rajeet-04/ringquad/DESIGN.md

# Morphing Aerial-Ground Quad: Design Spec (v0.5)

**Current simulation design:** independent lightweight propellers and wheel drives, upright 90° fold, 100 mm ring-axis standoff, rear wheel carriers, front steering with 25° stops, physical crowned rims and self-collision enabled. Nominal mass budget is 1.98 kg. See [REDESIGN.md](REDESIGN.md) for the mechanism and regression evidence. Earlier shared-motor results below are historical; hardware qualification remains open.

Status: layout and fold geometry agreed, pre-build. Simulation first (ROS 2 Jazzy, Gazebo Harmonic), hardware later.

Items marked **(default)** are my proposals, not yet confirmed.

## 1. Concept

A quadrotor with four arms. Each arm ends in a ring propeller: the blades (spokes) inside the ring make thrust, and the outer surface of the ring is a tire.

- **Flight:** arms spread in an X, the ring propellers spin horizontally and fly the vehicle.
- **Ground:** arms fold down and inward with a twist, so each ring propeller stands up like a car wheel facing forward. The same motors now spin the rings as wheels, and the vehicle drives like an RC car.

Springs at each arm hinge give suspension in ground mode.

## 2. Hardware layout

| Part | Count | Role |
|---|---|---|
| Rotor/wheel motors | 4 | One per arm tip. Spin the ring propeller for thrust in flight, and drive it as a wheel on the ground. |
| Fold motor | 1 | In the body, at center-of-mass height. Drives all four arm hinges through a shared linkage or gear train. |
| Hinge springs | 4 | One per arm at the body joint. Suspension in ground mode. |

## 3. Fold geometry and sizing

Computed with `geometry.py` (body frame: x forward, y left, z up; front-left arm, others mirrored).

**Chosen design: plain front-to-back hinge, 80° fold, arm 45° down on the ground, 10° camber.**

At this arm angle the hinge axis that does the "fold inward with a spin" comes out as a pure front-to-back axis (computed: -1.0, -0.004, -0.005). So each arm needs only a plain hinge, not a tilted one, which is much easier to build. A single 80° rotation turns the arm from the diagonal X pose to 45° down, and turns the ring from horizontal to an upright wheel with 10° negative camber.

Inputs: 27 cm ring outer diameter (10-inch prop + rim), 3 cm tread, 16 x 16 x 8 cm body, ring plane offset 3.5 cm from the arm (above the arm in flight, outside the body on the ground), 1 cm minimum gaps.

| Quantity | Value |
|---|---|
| Arm length (hinge to ring centre) | **12 cm** |
| Gap between rings in flight | 6.0 cm |
| Gap between front and rear rings on the ground | 6.1 cm |
| Body ground clearance | 17 cm |
| Wheelbase / track | 33 / 30.5 cm (ratio 1.09, good for tank steering) |
| CoM height on the ground | 21 cm |
| Sideways tip-over threshold | 0.73 g |

Trade-off, same 12 cm arm: lowering the arm angle on the ground lowers the body (more stable, less clearance) but makes the hinge axis tilted.

| Arm angle down | Clearance | Tip-over | Wheelbase/track | Hinge |
|---|---|---|---|---|
| 20° | 12.7 cm | 0.87 g | 1.33 | tilted |
| 30° | 14.5 cm | 0.80 g | 1.24 | tilted |
| **45°** | **17.0 cm** | **0.73 g** | **1.09** | **plain front-to-back** |

Assumes the CoM is at hinge height and ignores arm and ring mass; recompute with real masses from CAD.

## 4. Geometry rules

- Rotor plane at center-of-mass height in flight.
- Hinges at center-of-mass height, so folding does not shift the center of mass much.
- Ring propellers do not overlap in flight.
- In ground mode, front and rear rings on each side must not touch, and the body must clear the ground.

## 5. Motors: flight vs ground

- **Same motors in both modes.** In flight they spin fast for thrust. On ground they spin slowly as wheels.
- **Spin direction changes between modes.** In flight, diagonal pairs spin opposite ways to cancel torque. On ground, both wheels on one side must spin the same way to drive forward. So at least two motors reverse direction when switching modes, and all four reverse for driving backward. Motors and controllers must be bidirectional.
- **Low-speed torque (hardware).** Drone motors and normal ESCs are poor at slow, high-torque spinning. For hardware, use motor controllers with field-oriented control and position encoders, which handle both fast flight and slow wheel driving. In simulation this is just a joint velocity/torque limit.
- Blades still spin while driving, but at wheel speeds (around 150 RPM at 2 m/s for a 10-inch ring) they make negligible thrust.

## 6. Fold mechanism requirements

- All four arms move together from one command (one motor, shared linkage).
- Holds position without continuous motor torque (worm gear, lead screw or linkage that locks at end of travel).
- **Arms locked rigid in flight; springs active only in ground mode (default).** A sprung arm in flight wobbles under thrust and upsets attitude control.

## 7. Driving and steering

- **Tank-style (skid) steering (decided):** turn by spinning the left and right wheels at different speeds. Needs no extra parts. The 1.09 wheelbase-to-track ratio keeps turning torque reasonable.

## 8. Modes

| Mode | Motors | Fold | Controller |
|---|---|---|---|
| FLY | fast, thrust and attitude | spread, locked | flight controller |
| TRANSITION_TO_GROUND | land, spin down, stop | folding | mode-switch node |
| DRIVE | slow, as wheels, direction per side | folded, springs active | ground controller (skid steer) |
| TRANSITION_TO_FLY | stopped, then spin up | unfolding, then lock | mode-switch node |
| HOLD | stopped | either | safety supervisor |

The mode-switch node gates everything: only one controller (flight or ground) commands the motors at a time.

## 9. Simulation plan (Gazebo Harmonic + ROS 2 Jazzy)

- Model: body, four arms on front-to-back revolute hinges (80° fold), four ring propellers on continuous joints, spring-damper on the hinges, ring collision shape for wheel contact.
- Fold: one command drives all four hinges (mimic joints or one controller for all four).
- Thrust: per-rotor thrust and drag torque from rotor speed (Gazebo multicopter motor model or our own plugin).
- **Controllers written in ROS 2 (default):** own flight controller and own skid-steer ground controller, with the mode-switch node between them. PX4 cannot switch vehicle type mid-mission without custom work, and an own controller is a stronger portfolio piece. Revisit PX4 for hardware.
- **Sensors (default):** IMU, depth camera, 2D LiDAR.

## 10. Demo mission (default)

Take off, fly over a wall, land, fold, drive through a low tunnel it cannot fly through, unfold, take off, and land at a goal.

## 11. Key tests

1. Hover stability with arms spread and locked.
2. Fold cycle: FLY to DRIVE and back; time per transition and no ring/body collisions during the fold.
3. Landing onto rings and spring-damper response in DRIVE.
4. Straight-line driving and skid-steer turns: slip and path error.
5. Motor direction switch between modes is correct for all four motors.
6. Fault case: one motor failure during transition, and the mode-switch response.

## 12. Findings from simulation

**Ring inertia dominates yaw.** Each ring (60 g at 12–13.5 cm radius) has about 12x the spin inertia of a plain 10-inch prop. When the mixer changes rotor speeds to make yaw torque, the reaction from spinning the rings up or down kicks the body in yaw like a reaction wheel. For a step command this kick is roughly 300x the aerodynamic drag torque the mixer plans for. With normal quad yaw gains the motors chattered between full and zero and the vehicle lost roll control. Fix: yaw gains much lower than roll/pitch (attitude 2, rate 0.4). The unit-test simulator models motor lag and ring inertia, so it catches this.
- Hardware consequence: ring mass is a first-order design parameter. Lighter rings (or rings that do not spin, i.e. a fixed duct with the prop inside) give much better yaw control.

**Skid-steer turning jams in the physics engine.** DART limits tyre friction per direction (a pyramid), so a tyre sliding forward still grips fully sideways. With wheelbase/track 1.09 the robot could not turn on the spot until it broke loose in jerks. Fix in simulation: sideways tread friction 0.6, forward 1.0 (it must stay below 0.92 x forward). A yaw-rate loop on the IMU then tracks turn commands (1.01 rad/s for 1 rad/s).
- Hardware consequence: on real tyres the friction circle helps, but a wheelbase/track ratio near or above 1 still makes skid steering scrub hard. Keep the track at least as wide as the wheelbase.

**Same motors fly and drive.** One motor model per ring takes signed speed commands. Positive = upward thrust in flight; on the ground the controller maps body speed and yaw rate to signed wheel speeds. Spin direction per motor is handled in `mixer.py`.

## 13. Realistic tests (v0.5)

The first simulation used ideal motors: the physics engine could spin the rings up with up to 50 Nm. Real hardware cannot. These tests replace the ideal assumptions with real limits and are now the default in Gazebo and the unit tests.

**What was added**
- Motors: 0.4 Nm peak (10-inch class, ~700 KV on 4S), rotor inertia, blade drag and an estimate of rim skin drag. Python model in `ringquad_control/plant.py`; in Gazebo as the spin joints' torque limit (0.33 Nm after blade drag) and damping. Gazebo spin-up matches the model (~300 rad/s^2 for the 60 g ring).
- Sensing: 8 ms delay plus position, velocity, attitude and gyro noise in the model sweeps; gyro and accelerometer noise on the Gazebo IMU.
- `scripts/realism_sweep.py` compares rotors and gains; `scripts/drive_test.py` checks ground steering.

**Flight results** (model, 8 ms delay + noise, final gains)

| Rotor | 1 m step settle | max tilt | 1.5 N gust | hover power | flight time (4S 3000 mAh) |
|---|---|---|---|---|---|
| plain 10-inch prop | 2.6 s | 16 deg | 22 cm | 137 W | 10.9 min |
| ring 20 g | 2.6 s | 16 deg | 22 cm | 333 W | 4.5 min |
| ring 40 g | 2.6 s | 17 deg | 22 cm | 353 W | 4.2 min |
| ring 60 g (spec) | 2.6 s | 17 deg | 22 cm | 386 W | 3.9 min |

- **The 60 g ring flies, but only with gentler control.** With the first roll/pitch tuning it diverges; at 0.7x and 0.6x it crashes on a 2.8 m diagonal move; 0.5x works (attitude bandwidth ~6 rad/s). The lighter rings and a plain prop fly at every scale tested. Final gains: 0.5x, kept for all rotors.
- **Rim drag is the biggest cost.** The rim moves at ~70 m/s at hover; its skin drag (estimated ~0.09 Nm per ring, about as much as the blades) more than doubles hover power. Flight time drops from ~11 min to ~4–4.5 min whatever the ring weight. This is an estimate and the first thing to measure on a thrust stand.
- **Heavy rings also waste power on noise.** With sensor noise the 60 g rings burn ~15% more than the 20 g rings, constantly spun up and down by the controller.
- In Gazebo with realistic motors and a noisy IMU: take-off 2.1 cm, waypoint + 90 deg yaw 2.6 cm / 0.1 deg, landing fine.

**Ground results**
- **All-rubber tread cannot reliably skid-steer.** Direct-drive motors push each wheel with at most ~0.4 Nm / 0.135 m = 3 N. The four wheels then make at most ~1.5–1.8 Nm of turning moment, while the tyres' sideways grip resists with ~1.6 Nm (more on real rubber). In Gazebo, turning on the spot gave 0.00 rad/s, and large left/right speed differences made the wheels fight and stall the robot. The yaw-rate loop is now limited with anti-windup so it never stalls the drive.
- **Never fold with spinning rings.** A ring spinning at landing speed holds ~0.4 Nms; tipping its axis twists the robot. The controller now waits until all rings are below 5 rad/s.
- **Fold slowly.** A fast fold drags the ring edges over the floor against the motor brake; with realistic torque it twisted the robot by up to 80 deg. The fold is now ramped at 0.4 rad/s (~3.5 s); the twist dropped to about 1–2 deg.
- **Candidate fix: omni rollers on the tread.** Passive rollers around the rim cut sideways friction to ~0.05 and the turning resistance to ~0.14 Nm. In Gazebo (`tread:=omni`) arc turns then track exactly (0.30 / 0.60 / 0.99 rad/s for 0.3 / 0.6 / 1.0 requested), but the robot has no sideways grip and skids on corrections. `tread:=mixed` (omni front, rubber rear) is the standard answer (it pivots about the rear axle like a wheelchair on casters) and also tracks arcs exactly, but line following was erratic and inconsistent between runs, while the same follower converges in a kinematic model with lag.
- **Simulation limit.** Results that depend on tyre contact (directional friction on a cambered ring edge, rollers) were not consistent between runs in DART: with the rubber tread a 0.3 rad/s turn request while driving gave 0.00 rad/s in one session and 0.30 rad/s in another. They should be settled on a physical test rig, not by more simulation tuning.

**Historical cylinder-contact demo results (before the tunnel-control branch).** The flight legs work. The tunnel leg fails: with the spec rubber tread the robot cannot steer and needs ~0.9 deg alignment to clear the 7–8 cm gaps over 4 m, which landing + folding do not reliably give (+-2 deg); with the mixed tread, line following is not yet reliable in simulation. The mission now lines up in the air, checks alignment after folding, hops and retries if needed, and stops safely on drift. The recorded demo in `media/` was made with ideal motors before these tests.

**Would it work if built?** Flight: yes with a 20–40 g ring (or the 60 g ring with gentle control), but expect ~4 min flights unless rim drag is lower than estimated. Ground: not with an all-rubber tread on grippy floors; it needs a steerable tread (mixed omni/rubber is the best candidate) or turns done in the air.

## 14. Recommended physical tests before building the full robot

1. **Thrust stand, one ring propeller** (60 g and a ~20 g carbon version): thrust, shaft power and spin-up time vs speed. Confirms or kills the rim-drag estimate and the motor sizing.
2. **Folding arm prototype:** play, locking, weight, and folding with the ring stopped vs spinning.
3. **Two-axle test cart** with the folded geometry and the candidate treads (rubber, omni, mixed) on the target floors: turning on the spot, arcs, straight-line drift.

## 15. Open questions

- Ring weight and whether the ring spins with the prop (see findings and section 13).
- Tread: rubber, omni or mixed (section 13).
- Fold motor type: servo, geared brushless or lead screw.
- Failure policy when a motor fails in DRIVE.

## 16. Status and next steps

Done in simulation: model, fold, flight (take-off, waypoint + yaw, land), driving, mode switching; unit and end-to-end tests. Demo course (wall + tunnel) and autonomous mission (`demo.launch.py`), recorded in `media/` with ideal motors. Realistic motors, drag and sensor noise are now the default (section 13): the original tunnel leg failed; isolated validation of the updated mission is documented in section 17 and SIMULATION_RESULTS.md.

The mission uses known waypoints and ground-truth odometry; it does not perceive the course yet.

Next:
1. The physical tests in section 14, then pick the ring weight and tread.
2. Hinge spring-damper suspension in DRIVE (currently a stiff hold).
3. State estimation from IMU instead of ground-truth odometry.
4. Sensors (depth camera, 2D LiDAR) so the robot finds the wall and tunnel itself.
5. GPU rendering (Vulkan through Podman's libkrun to Metal) to speed up the GUI and recording.

## 17. Tunnel-control branch (2026-11-13)

The experiment uses a convex rounded tread collision mesh and DART's Bullet collision detector. The full demo defaults to omni tread; mixed and rubber are also exercised in isolated full-mission tests; see SIMULATION_RESULTS.md. This is a contact approximation, not a model of individual passive rollers or proof of hardware capability.

The mission now actively aligns on the ground to within 1 degree before forward motion, with a 60 s ground-alignment timeout and compensated aerial retries, rather than accepting up to 10 degrees after folding. It uses ROS simulation time, a landing point at x=3.8 m, and retains the original 5 cm strict cross-track stop. Headless launch is available through `gui:=false`. `scripts/demo_test.py` starts fresh worlds and fails on abort, timeout, or missing completion; run it in the sourced ROS workspace.

The original tests did not isolate Gazebo transport between runs. Orphaned servers were found during follow-up validation, so those inconsistent runs cannot distinguish contact dynamics from cross-talk. The corrected harness uses locked ROS domains, unique Gazebo partitions, and full process-group cleanup. Ground-alignment stalls now use the existing aerial retry with measured heading compensation, bounded to three attempts. See SIMULATION_RESULTS.md for isolated mixed/rubber/omni validation; none of these tests establish hardware steering bandwidth.

## 18. Isolated follow-up validation

The follow-up fixes test isolation/cleanup, noisy low-rate yaw integration, and stalled alignment recovery. Waypoint completion also waits for yaw convergence. The final ground alignment allowance is 60 simulated seconds, with three landing attempts and the original 5 cm strict cross-track stop. Two isolated complete missions per tread (mixed, rubber, omni) passed; see SIMULATION_RESULTS.md for per-run timing, configuration differences, and remaining steering-bandwidth limitations. No steering mechanism or motor/friction limit was changed.

## 19. Optional front-steering mechanism

The user-authorized hardware variant adds two 20 g front steering knuckles and ideal positive locks that engage when the arms are below 75 degrees fold. Ground control uses Ackermann angles and wheel speeds; flight allocation accounts for added mass and forward CoM shift. Servo-only steering hold caused a flight regression and was replaced by the explicit lock. The fixed-wheel model remains the default. See STEERING.md and SIMULATION_RESULTS.md for hardware assumptions, measured yaw tracking, and complete-mission validation.
