rajeet-04/ringquad/hardware-blockers/fixtures/synthetic-thrust.csv

rotor | omega_rad_s | thrust_N | current_A | voltage_V | temperature_C
fl | 400 | 1.3439999999999999 | 10 | 14.8 | 45
fl | 500 | 2.0999999999999996 | 10 | 14.8 | 45
fl | 600 | 3.0239999999999996 | 10 | 14.8 | 45
fl | 700 | 4.116 | 10 | 14.8 | 45
fl | 800 | 5.3759999999999994 | 10 | 14.8 | 45
fl | 900 | 6.803999999999999 | 10 | 14.8 | 45
fl | 1000 | 8.399999999999999 | 10 | 14.8 | 45
fl | 1040 | 9.085439999999998 | 10 | 14.8 | 45
fr | 400 | 1.2767999999999997 | 10 | 14.8 | 45
fr | 500 | 1.9949999999999994 | 10 | 14.8 | 45
fr | 600 | 2.8727999999999994 | 10 | 14.8 | 45
fr | 700 | 3.9101999999999992 | 10 | 14.8 | 45
fr | 800 | 5.107199999999999 | 10 | 14.8 | 45
fr | 900 | 6.463799999999998 | 10 | 14.8 | 45
fr | 1000 | 7.979999999999998 | 10 | 14.8 | 45
fr | 1040 | 8.631167999999999 | 10 | 14.8 | 45
rl | 400 | 1.2096 | 10 | 14.8 | 45
rl | 500 | 1.89 | 10 | 14.8 | 45
rl | 600 | 2.7216 | 10 | 14.8 | 45
rl | 700 | 3.7043999999999997 | 10 | 14.8 | 45
rl | 800 | 4.8384 | 10 | 14.8 | 45
rl | 900 | 6.1236 | 10 | 14.8 | 45
rl | 1000 | 7.56 | 10 | 14.8 | 45
rl | 1040 | 8.176896 | 10 | 14.8 | 45
rr | 400 | 1.1423999999999999 | 10 | 14.8 | 45
rr | 500 | 1.785 | 10 | 14.8 | 45
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
