rajeet-04/ringquad/hardware-blockers/cad/rear_v_race.step

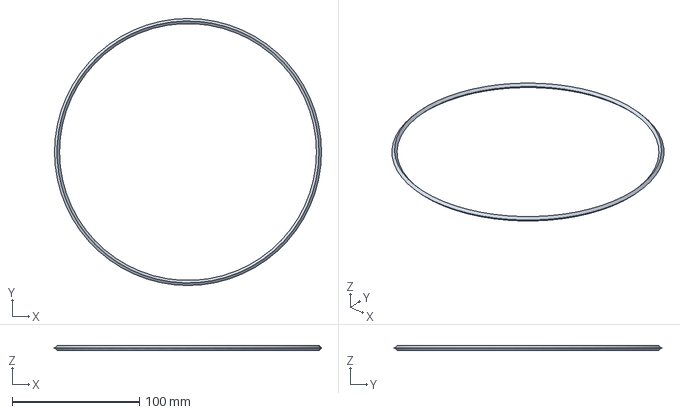
[picture p3: CAD file, 2026-11-13]
hardware-blockers/cad/rear_v_race.step
210.0 x 210.0 x 4.00 mm
