rajeet-04/ringquad/src/ringquad_description/meshes/crowned_rim.stl

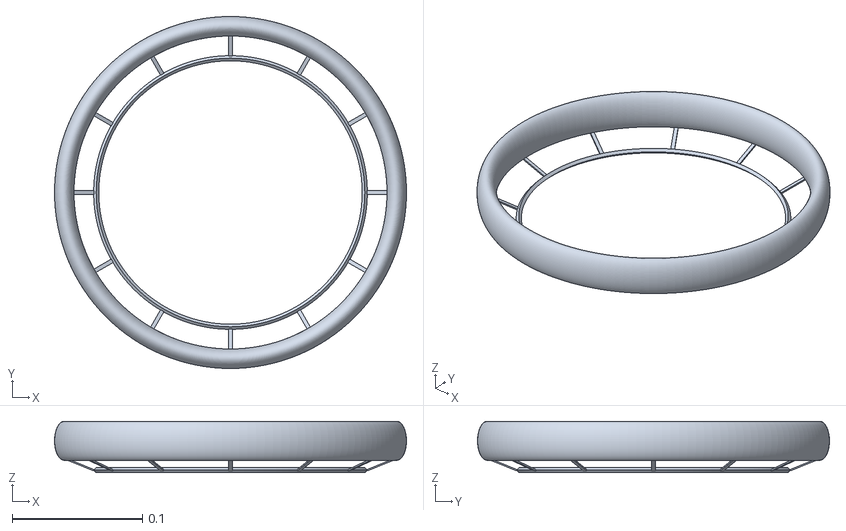
[picture p4: CAD file, 2026-11-13]
src/ringquad_description/meshes/crowned_rim.stl
0.27 x 0.27 x 0.0395
