rajeet-04/ringquad/src/ringquad_description/meshes/rear_race_segments/race_14.stl

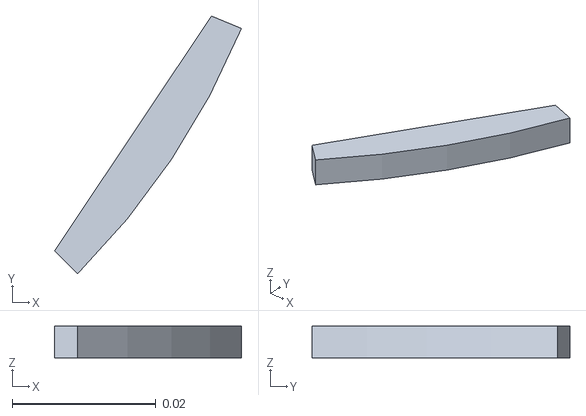
[picture p5: CAD file, 2026-11-13]
src/ringquad_description/meshes/rear_race_segments/race_14.stl
0.026 x 0.0359 x 0.0044
