rajeet-04/ringquad/src/ringquad_description/meshes/rear_tab_segments/tab_9.stl

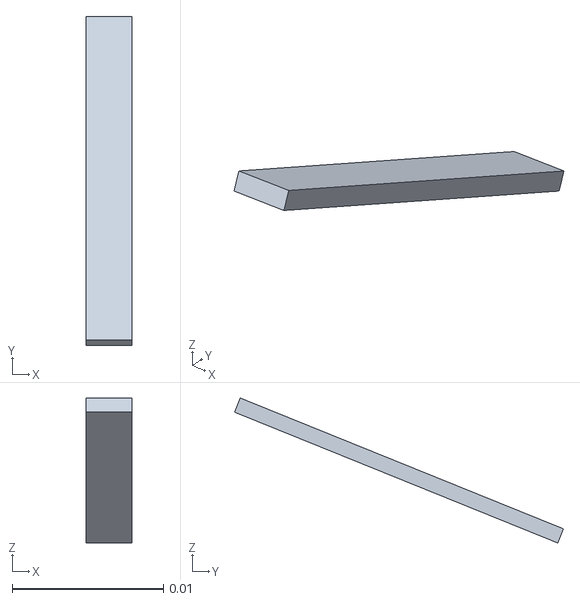
[picture p6: CAD file, 2026-11-13]
src/ringquad_description/meshes/rear_tab_segments/tab_9.stl
0.00303 x 0.0218 x 0.0096
