rajeet-04/ringquad/hardware-blockers/cad/latch_tongue.step

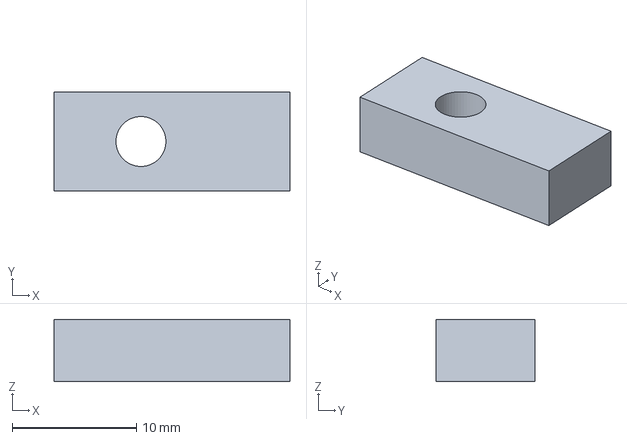
[picture p7: CAD file, 2026-11-13]
hardware-blockers/cad/latch_tongue.step
19.0 x 8.00 x 5.00 mm
