rajeet-04/ringquad/src/ringquad_description/meshes/crowned_tread_hull.stl

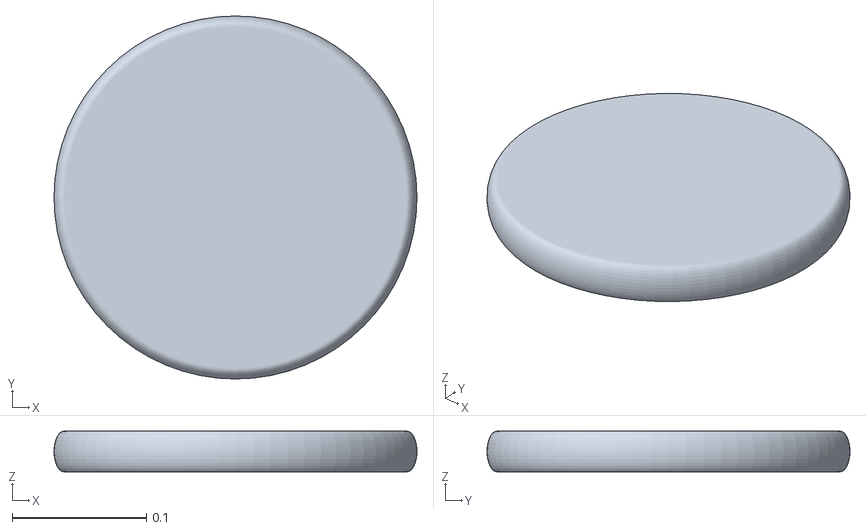
[picture p8: CAD file, 2026-11-13]
src/ringquad_description/meshes/crowned_tread_hull.stl
0.27 x 0.27 x 0.0304
