rajeet-04/ringquad/src/ringquad_description/meshes/rear_tab_segments/tab_7.stl

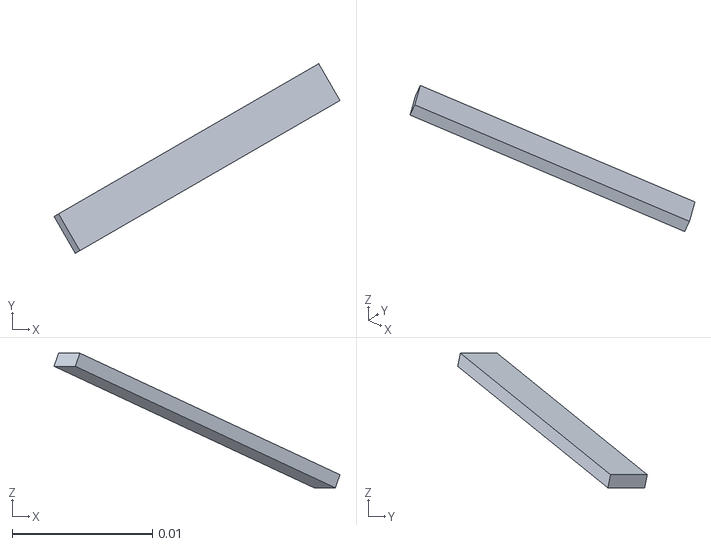
[picture p9: CAD file, 2026-11-13]
src/ringquad_description/meshes/rear_tab_segments/tab_7.stl
0.0204 x 0.0135 x 0.0096
