rajeet-04/ringquad/hardware-blockers/cad/latch_pin.step

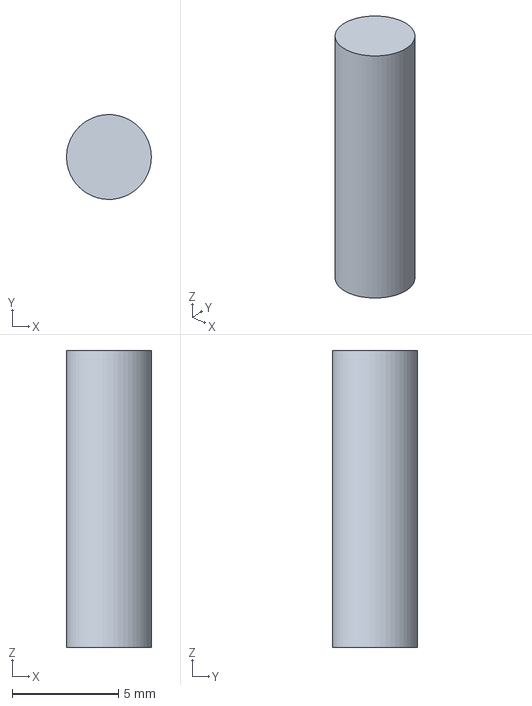
[picture p10: CAD file, 2026-11-13]
hardware-blockers/cad/latch_pin.step
4.00 x 4.00 x 14.0 mm
