rajeet-04/ringquad/src/ringquad_description/meshes/rear_race_segments/race_11.stl

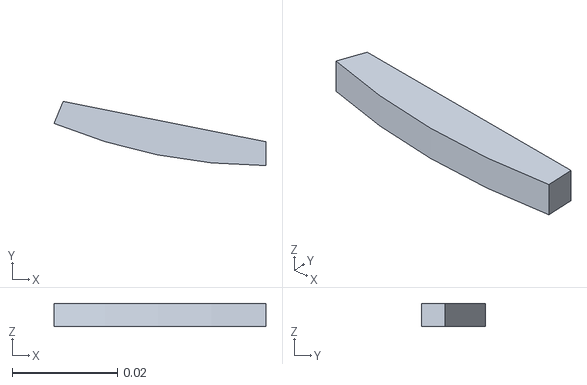
[picture p11: CAD file, 2026-11-13]
src/ringquad_description/meshes/rear_race_segments/race_11.stl
0.0403 x 0.0122 x 0.0044
