rajeet-04/ringquad/src/ringquad_description/meshes/rounded_tread.stl

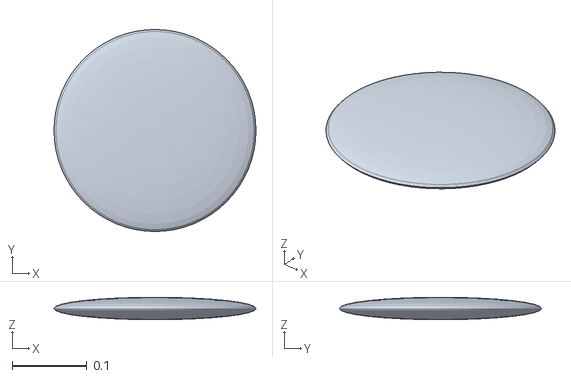
[picture p12: CAD file, 2026-11-13]
src/ringquad_description/meshes/rounded_tread.stl
0.27 x 0.27 x 0.03
