rajeet-04/ringquad/hardware-blockers/cad/latch_ears.step

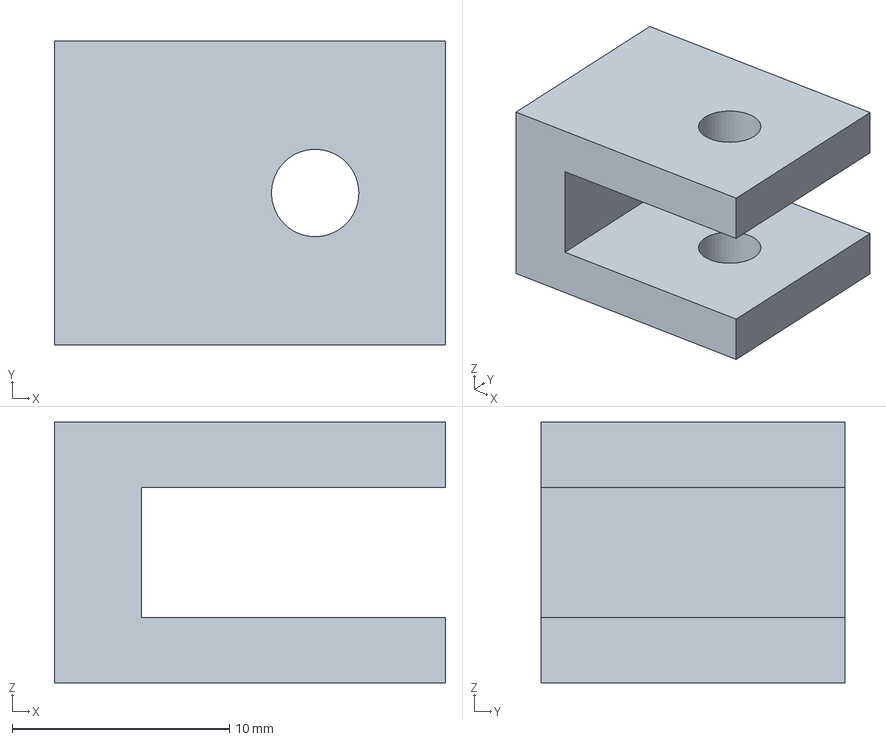
[picture p13: CAD file, 2026-11-13]
hardware-blockers/cad/latch_ears.step
18.0 x 14.0 x 12.0 mm
