rajeet-04/ringquad/hardware-blockers/cad/v_roller.step

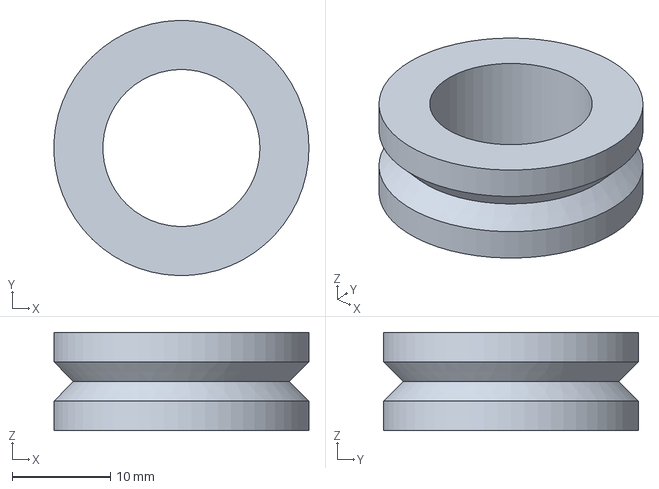
[picture p14: CAD file, 2026-11-13]
hardware-blockers/cad/v_roller.step
26.0 x 26.0 x 10.0 mm
