rajeet-04/ringquad/hardware-blockers/cad/carrier.step

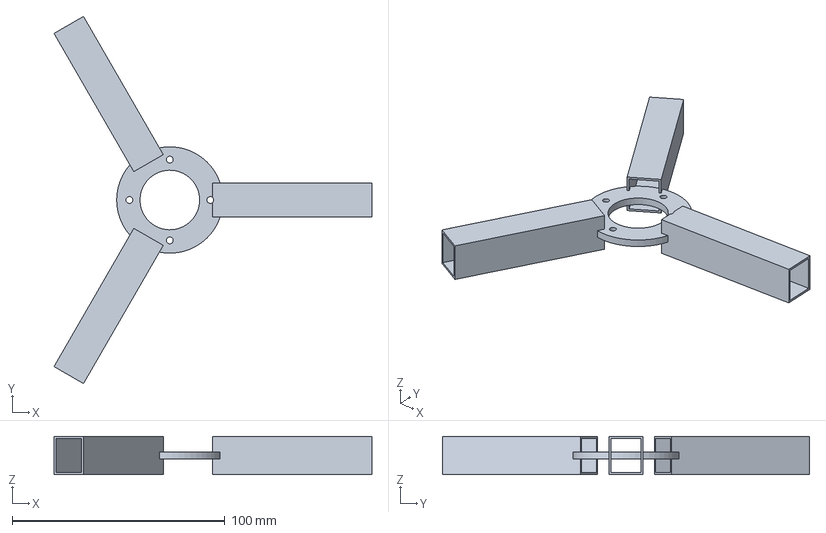
[picture p15: CAD file, 2026-11-13]
hardware-blockers/cad/carrier.step
149.4 x 172.5 x 18.0 mm
