rajeet-04/ringquad/hardware-blockers/cad/standoff.step

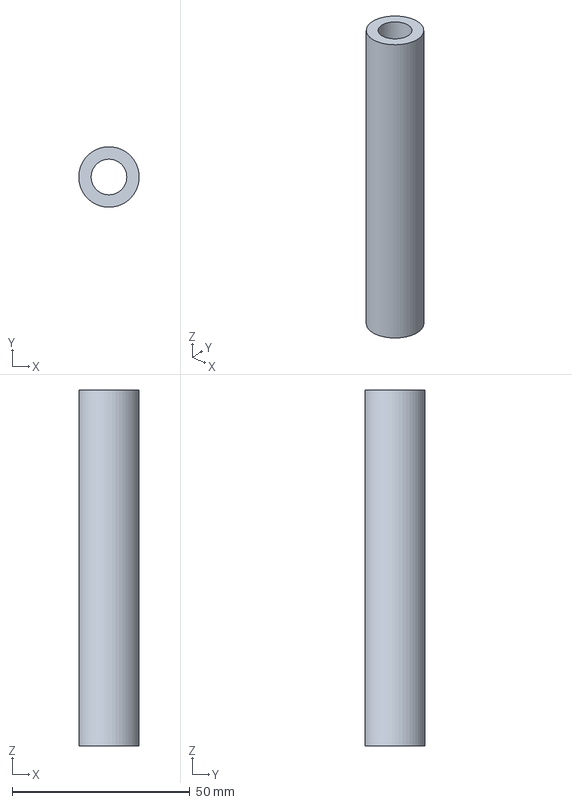
[picture p16: CAD file, 2026-11-13]
hardware-blockers/cad/standoff.step
17.0 x 17.0 x 100.0 mm
