rajeet-04/ringquad/(list of files, cad)

Other CAD files:
src/ringquad_description/meshes/rear_race_segments/race_1.stl
src/ringquad_description/meshes/rear_tab_segments/tab_1.stl
src/ringquad_description/meshes/rear_race_segments/race_6.stl
src/ringquad_description/meshes/rear_tab_segments/tab_10.stl
src/ringquad_description/meshes/rear_race_segments/race_7.stl
src/ringquad_description/meshes/rear_tab_segments/tab_3.stl
src/ringquad_description/meshes/rear_race_segments/race_15.stl
src/ringquad_description/meshes/rear_tab_segments/tab_0.stl
src/ringquad_description/meshes/rear_race_segments/race_9.stl
src/ringquad_description/meshes/rear_tab_segments/tab_4.stl
src/ringquad_description/meshes/rear_race_segments/race_5.stl
src/ringquad_description/meshes/rear_tab_segments/tab_2.stl
src/ringquad_description/meshes/rear_race_segments/race_8.stl
src/ringquad_description/meshes/rear_tab_segments/tab_5.stl
src/ringquad_description/meshes/rear_race_segments/race_13.stl
src/ringquad_description/meshes/rear_tab_segments/tab_11.stl
src/ringquad_description/meshes/rear_race_segments/race_0.stl
src/ringquad_description/meshes/rear_tab_segments/tab_6.stl
src/ringquad_description/meshes/rear_race_segments/race_4.stl
src/ringquad_description/meshes/rear_tab_segments/tab_8.stl
src/ringquad_description/meshes/rear_race_segments/race_3.stl
src/ringquad_description/meshes/rear_race_segments/race_2.stl
src/ringquad_description/meshes/rear_race_segments/race_12.stl
src/ringquad_description/meshes/rear_race_segments/race_10.stl
hardware-blockers/cad/carrier.stl
hardware-blockers/cad/latch_ears.stl
hardware-blockers/cad/latch_pin.stl
hardware-blockers/cad/latch_tongue.stl
hardware-blockers/cad/rear_v_race.stl
hardware-blockers/cad/standoff.stl
hardware-blockers/cad/v_roller.stl
