rajeet-04/ringquad/hardware-blockers/results/bullet-mission-loads.csv

time | corner | base_z | fold | steer | steer_rate | force_x | force_y | force_z | torque_x | torque_y | torque_z | lock_torque | lock_broken | fold_velocity
0.002 | 0 | 0.0999706 | 0 | -4.6936e-12 | -1.24599e-09 | -3.64886e-08 | -2.37193e-09 | -3.01558e-08 | 1.19678e-10 | -7.23998e-09 | 1.24941e-17 | 2.06857e-09 | 0 | 4.44089e-16
0.002 | 1 | 0.0999706 | 0 | 4.6936e-12 | 1.24599e-09 | -3.64886e-08 | 2.3719e-09 | -3.01558e-08 | -1.19677e-10 | -7.23998e-09 | 1.24086e-17 | -2.06857e-09 | 0 | 0
0.006 | 0 | 0.0997942 | 0 | -1.08919e-11 | -1.20573e-09 | -5.28052e-08 | 6.19649e-09 | -2.259e-08 | -3.12652e-10 | -4.81276e-09 | 8.12117e-18 | 9.08061e-10 | 0 | 0
0.006 | 1 | 0.0997942 | 0 | 1.08919e-11 | 1.20573e-09 | -5.28052e-08 | -6.19649e-09 | -2.259e-08 | 3.12651e-10 | -4.81276e-09 | 8.24362e-18 | -9.08061e-10 | 0 | 0
0.01 | 0 | 0.099461 | -1.02812e-11 | -1.43046e-11 | 8.77401e-10 | -4.29507e-08 | -8.71879e-08 | 5.59802e-09 | 4.73033e-09 | -5.49976e-09 | 8.6257e-12 | 7.77901e-10 | 0 | -1.02812e-08
0.01 | 1 | 0.099461 | -1.51699e-30 | 1.43046e-11 | -8.77401e-10 | -3.89376e-08 | 2.87545e-08 | -7.91333e-09 | -1.11969e-09 | -5.49976e-09 | 8.6257e-12 | -7.77901e-10 | 0 | 0
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
