rajeet-04/ringquad/hardware-blockers/results/clear-carrier-loads.csv

time | corner | base_z | fold | steer | steer_rate | force_x | force_y | force_z | torque_x | torque_y | torque_z | lock_torque | lock_broken
0.002 | 0 | 0.0999706 | 1.81447e-21 | -5.06471e-23 | 4.63871e-19 | 6.88893e-18 | -2.30438e-17 | 2.57929e-16 | 1.1627e-18 | -2.89291e-19 | -2.47366e-34 | 3.08711e-19 | 0
0.002 | 1 | 0.0999706 | 1.81447e-21 | 5.06471e-23 | -4.63871e-19 | 6.88893e-18 | 2.30438e-17 | 2.57929e-16 | -1.1627e-18 | -2.89291e-19 | -2.53243e-34 | -3.08711e-19 | 0
0.006 | 0 | 0.0997942 | 1.81447e-21 | -5.20579e-22 | -4.79892e-20 | 3.12473e-18 | -1.67792e-32 | 2.50756e-16 | 9.3445e-34 | 6.77433e-20 | 1.61623e-34 | 6.82686e-20 | 0
0.006 | 1 | 0.0997942 | 1.81447e-21 | 5.20579e-22 | 4.79892e-20 | 3.12473e-18 | 1.82234e-33 | 2.50756e-16 | -4.08823e-36 | 6.77433e-20 | 1.61623e-34 | -6.82686e-20 | 0
0.01 | 0 | 0.099461 | 1.81447e-21 | -7.2617e-22 | -4.18528e-20 | 3.10638e-18 | 2.3252e-32 | 2.50756e-16 | -1.17317e-33 | 1.05674e-19 | -1.14907e-35 | 2.9071e-20 | 0
0.01 | 1 | 0.099461 | 1.81447e-21 | 7.2617e-22 | 4.18528e-20 | 3.10638e-18 | -2.09246e-32 | 2.50756e-16 | 1.05586e-33 | 1.05674e-19 | -5.61324e-36 | -2.9071e-20 | 0
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
