rajeet-04/ringquad/hardware-blockers/results/finite-fold-final/loads.csv

time | corner | base_z | fold | steer | steer_rate | force_x | force_y | force_z | torque_x | torque_y | torque_z | lock_torque | lock_broken | fold_velocity
0.002 | 0 | 0.0999706 | 5.51651e-29 | 1.48933e-21 | 4.83033e-19 | 1.46542e-17 | -9.86076e-32 | 3.17054e-16 | 4.62223e-33 | 1.19112e-18 | -8.90975e-38 | -6.0378e-19 | 0 | 2.75826e-26
0.002 | 1 | 0.0999706 | 5.51651e-29 | -1.48933e-21 | -4.83033e-19 | 1.46542e-17 | -4.93038e-32 | 3.17054e-16 | 4.62223e-33 | 1.19112e-18 | 2.77654e-35 | 6.0378e-19 | 0 | 2.75826e-26
0.006 | 0 | 0.0997942 | 1.65495e-28 | 3.42541e-21 | 3.96718e-19 | 1.4591e-17 | -2.46519e-32 | 3.17054e-16 | 0 | 8.93868e-19 | 1.0902e-35 | -2.73666e-19 | 0 | 2.75826e-26
0.006 | 1 | 0.0997942 | 1.65495e-28 | -3.42541e-21 | -3.96718e-19 | 1.4591e-17 | 2.46519e-32 | 3.17054e-16 | 0 | 8.93868e-19 | 3.49159e-36 | 2.73666e-19 | 0 | 2.75826e-26
0.01 | 0 | 0.0994633 | 5.01396e-05 | 1.19949e-06 | 0.00119949 | 0.0138464 | 0.636773 | -0.281754 | -0.0321291 | 6.45817e-05 | -1.37427e-22 | -1.74262e-19 | 0 | 0.0501396
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
