rajeet-04/ringquad/hardware-blockers/results/finite-latch-loads.csv

time | corner | base_z | fold | steer | steer_rate | force_x | force_y | force_z | torque_x | torque_y | torque_z | lock_torque | lock_broken
0.002 | 0 | 0.0999706 | 2.35313e-29 | 1.4682e-20 | 5.78057e-18 | 9.08399e-17 | 2.46519e-32 | -2.04697e-16 | -7.70372e-34 | 6.80885e-18 | -2.91899e-35 | -3.11551e-18 | 0
0.002 | 1 | 0.0999706 | 2.35313e-29 | -1.4682e-20 | -5.78057e-18 | 9.08399e-17 | 2.46519e-32 | -2.04697e-16 | -1.54074e-33 | 6.80885e-18 | -6.37436e-35 | 3.11551e-18 | 0
0.006 | 0 | 0.0997942 | 7.0594e-29 | 3.18912e-20 | 3.37358e-18 | 9.12339e-17 | -1.2326e-32 | -2.04697e-16 | 7.70372e-34 | 5.41499e-18 | 5.40491e-35 | -1.37351e-18 | 0
0.006 | 1 | 0.0997942 | 7.0594e-29 | -3.18912e-20 | -3.37358e-18 | 9.12339e-17 | 1.2326e-32 | -2.04697e-16 | -7.70372e-34 | 5.41499e-18 | 4.92834e-35 | 1.37351e-18 | 0
0.01 | 0 | 0.099461 | 1.17657e-28 | 4.12964e-20 | 1.85105e-18 | 9.11175e-17 | -1.2326e-32 | -2.04697e-16 | 7.70372e-34 | 5.27891e-18 | -1.25352e-35 | -7.52801e-19 | 0
0.01 | 1 | 0.099461 | 1.17657e-28 | -4.12964e-20 | -1.85105e-18 | 9.11175e-17 | 1.2326e-32 | -2.04697e-16 | -7.70372e-34 | 5.27891e-18 | -1.71058e-35 | 7.52801e-19 | 0
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
