rajeet-04/ringquad/src/ringquad_control/ringquad_control/flight.py

"""Geometric position and attitude controller (after Lee, Leok, McClamroch 2010).

Position PID -> desired force vector -> desired attitude and collective thrust.
Attitude error on SO(3) -> body torque. All quantities in SI units.
World frame: z up. Body frame: x forward, y left, z up.
"""
import math
from dataclasses import dataclass, field

import numpy as np

from . import params as p

E3 = np.array([0.0, 0.0, 1.0])


def vee(m):
    return np.array([m[2, 1], m[0, 2], m[1, 0]])


def quat_to_rot(x, y, z, w):
    return np.array([
        [1 - 2 * (y * y + z * z), 2 * (x * y - z * w), 2 * (x * z + y * w)],
        [2 * (x * y + z * w), 1 - 2 * (x * x + z * z), 2 * (y * z - x * w)],
        [2 * (x * z - y * w), 2 * (y * z + x * w), 1 - 2 * (x * x + y * y)],
    ])


def yaw_of(rot):
    return math.atan2(rot[1, 0], rot[0, 0])


@dataclass
class Gains:
    kp: np.ndarray = field(default_factory=lambda: np.array([4.0, 4.0, 6.0]))
    kd: np.ndarray = field(default_factory=lambda: np.array([3.5, 3.5, 4.5]))
    ki: np.ndarray = field(default_factory=lambda: np.array([1.5, 1.5, 3.0]))
    i_max: float = 4.0                 # m/s^2, integrator clamp
    i_settle_speed: float = 0.3       # allow correction at a persistent off-target equilibrium
    k_att_i: np.ndarray = field(default_factory=lambda: np.array([5.0, 5.0, 0.05]))
    att_i_max: float = 8.0             # angular-acceleration bias bound, rad/s^2
    i_zone: float = 0.3                # m, integrate only within this error
    # Yaw gains are ~20x lower than roll/pitch: a yaw torque command changes rotor speeds, and
    # spinning the heavy rings up/down kicks the body far harder than the drag torque the
    # mixer plans for (see params.RING_IZZ). Higher yaw gains chatter and saturate the motors.
    # Roll/pitch are 0.5x the first tuning (attitude bandwidth ~6 rad/s): with realistic
    # torque-limited motors the 60 g rings spin up too slowly for faster attitude control.
    # The first tuning diverges; 0.7x and 0.6x crash on a 2.8 m diagonal move
    # (scripts/realism_sweep.py, test_flight.py). Lighter rings and plain props fly fine at 0.5x.
    k_att: np.ndarray = field(default_factory=lambda: np.array([37.5, 37.5, 2.0]))
    k_rate: np.ndarray = field(default_factory=lambda: np.array([10.0, 10.0, 0.4]))
    max_tilt: float = math.radians(30)
    max_accel_z: float = 5.0


class FlightController:
    def __init__(self, gains=None, mass=p.MASS):
        self.mass = mass
        self.g = gains or Gains()
        self.integral = np.zeros(3)
        self.attitude_integral = np.zeros(3)
        self.acc_excess = np.zeros(3)

    def reset(self):
        self.integral[:] = 0.0
        self.attitude_integral[:] = 0.0
        self.acc_excess[:] = 0.0

    def update(self, pos, vel, rot, rate, pos_sp, yaw_sp, dt, vel_sp=None):
        """Returns (collective thrust N, body torque Nm)."""
        g = self.g
        vel_sp = np.zeros(3) if vel_sp is None else vel_sp

        e_pos = pos_sp - pos
        # Integrate near the reference or at a settled, biased equilibrium.
        # Freeze components that would push farther into translation saturation.
        learning = (np.abs(e_pos) < g.i_zone) | (np.linalg.norm(vel) < g.i_settle_speed)
        learning &= (self.acc_excess * e_pos <= 0) | (np.abs(self.acc_excess) < 1e-6)
        self.integral = np.clip(self.integral + learning * g.ki * e_pos * dt, -g.i_max, g.i_max)
        acc = g.kp * e_pos + g.kd * (vel_sp - vel) + self.integral

        requested_acc = acc.copy()
        # limit tilt and vertical acceleration
        acc[2] = np.clip(acc[2], -g.max_accel_z, g.max_accel_z)
        a_xy_max = math.tan(g.max_tilt) * (p.GRAVITY + acc[2])
        a_xy = np.linalg.norm(acc[:2])
        if a_xy > a_xy_max:
            acc[:2] *= a_xy_max / a_xy

        self.acc_excess = requested_acc - acc

        force = self.mass * (acc + p.GRAVITY * E3)
        thrust = float(force @ (rot @ E3))

        b3 = force / np.linalg.norm(force)
        b1c = np.array([math.cos(yaw_sp), math.sin(yaw_sp), 0.0])
        b2 = np.cross(b3, b1c)
        b2 /= np.linalg.norm(b2)
        rot_sp = np.column_stack([np.cross(b2, b3), b2, b3])

        e_rot = 0.5 * vee(rot_sp.T @ rot - rot.T @ rot_sp)
        # Learn only during moderate, settled attitude errors; large manoeuvres
        # and high rates cannot wind up this bounded disturbance estimate.
        if np.linalg.norm(e_rot) < .5 and np.linalg.norm(rate) < 1.0:
            self.attitude_integral = np.clip(
                self.attitude_integral - g.k_att_i * e_rot * dt, -g.att_i_max, g.att_i_max)
        ang_acc = -g.k_att * e_rot - g.k_rate * rate + self.attitude_integral
        torque = p.INERTIA @ ang_acc + np.cross(rate, p.INERTIA @ rate)

        return max(thrust, 0.0), torque
