rajeet-04/ringquad/(commit log)

2026-10-14 Gazebo model: fold, drive and smoke test working
    - Rename ring joints to spin_* (SDF needs unique link and joint names)
    - Stiffer fold hold so hinges reach 80 deg under the robot's weight
    - Ground-truth odometry on /odom
    - scripts/smoke_test.py: fold, drive forward, unfold
    - run.sh: allow noVNC to bind port 80 under rootless Podman
2026-10-14 Flight: motor models, geometric controller, modes and mission test
    - One multicopter motor model per ring: thrust in flight, signed wheel speed on the ground
    - ringquad_control: mixer, geometric position/attitude controller, skid-steer yaw-rate loop,
    ROS node with idle/fly/land/drive modes
    - Low yaw gains: spinning the heavy rings up/down kicks the body in yaw far more than drag torque
    - Tread friction lower sideways than forward so skid-steer turns do not jam in DART
    - World file with 1 ms physics and IMU; IMU sensor and 250 Hz ground-truth odometry
    - Unit tests (rigid body with motor lag and ring inertia) and end-to-end mission test
    - Spin joint effort limit raised: it caps the physics e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
2026-10-14 Demo course and autonomous mission
    - worlds/demo.sdf: wall to fly over, tunnel too narrow to fly through, three pads;
    tunnel side walls see-through so the camera shows the robot inside
    - mission node: take off, fly over the wall, land, fold, drive through the tunnel,
    unfold, fly to the goal pad and land; timeouts abort to a landing
    - Stanley line following for driving (ground.py) with unit tests
    - demo.launch.py runs the course and mission in one command; world launch argument
    - media/: real-time MP4 and 2x GIF of the run
2026-10-14 Realistic tests: torque-limited motors, drag, sensor noise
    - plant.py: flight model with 0.4 Nm motors, ring and rotor inertia, blade and rim drag;
    unit tests now run on it (60 g ring)
    - realism_sweep.py: rotors x gains x sensing (8 ms delay + noise); 60 g ring needs 0.5x
    roll/pitch gains, rim drag cuts flight time to ~4 min (estimate)
    - Gazebo: spin joints torque-limited with rim-drag damping; IMU noise
    - Controller: never fold spinning rings, ramp the fold at 0.4 rad/s, yaw-rate loop limited
    with anti-windup so it cannot stall the drive
    - Mission: line up in the air, check after folding, hop and retry; stop on drift in the tunnel
    - tread launch option: rubber (spec), omni, mixed (omn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
2026-11-13 Stabilize omni-tread demo with rounded contact and ground alignment
2026-11-13 Add optional front steering with flight lock and isolated validation
2026-11-13 Separate propeller and wheel drives and validate revised hardware geometry
    Add upright crowned wheels, rear carriers, finite independent wheel drives, footprint guards and calibrated mass handling. Preserve failed design trials and record eight passing missions, 44 automated tests, interface checks and the remaining hardware qualification limits.
2026-11-13 Specify hardware candidate and validate finite actuators with repaired contact physics
